maci-j/arduino-thermostat/images/breadboard.jpg

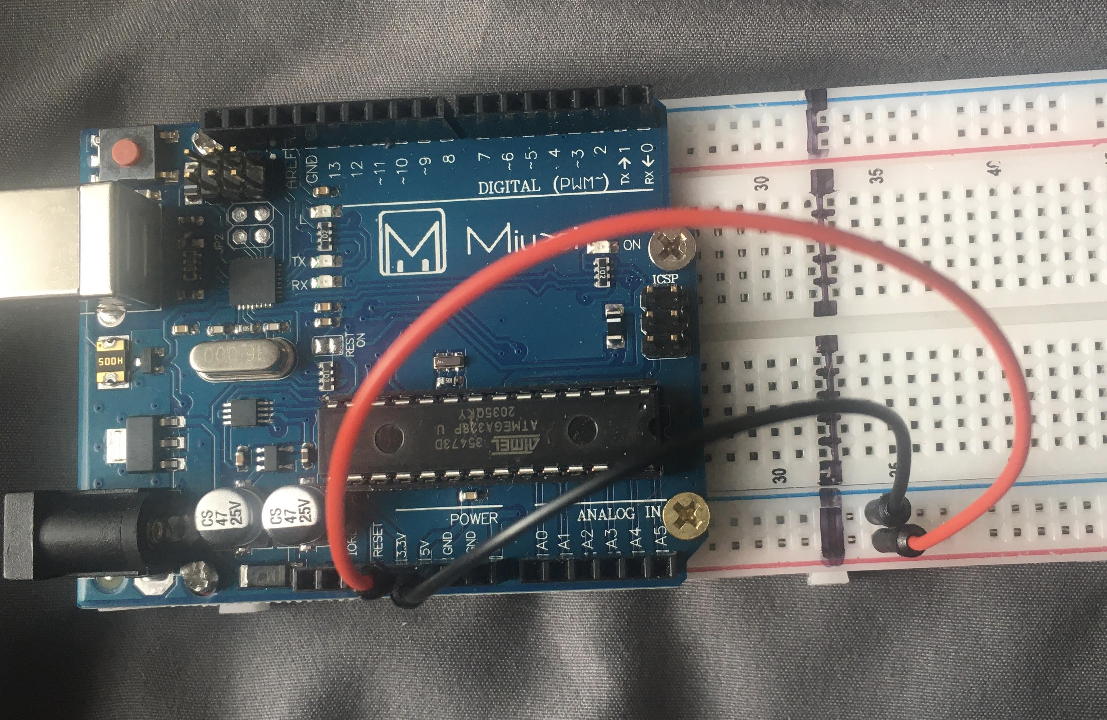
images/breadboard.jpg
